kawfey/k3ng_w0odj_keyer-PCB/README.md

# k3ng_w0odj_keyer-PCB

Original K3NG CW Keyer PCB created with Kicad by W0ODJ. https://groups.io/g/radioartisan/message/8825
