kawfey/k3ng_w0odj_keyer-PCB/BOM Mega K3NG.xlsx

Qty | Value | Ref | Description | Price Ea | Price Total | Mouser # / Link
1 |  | BZ1 | Buzzer | $2.18 | $2.18 | 810-SD1614T5-B1
3 | 10nf | C1, C2, C3 | Ceramic Capacitor | $0.03 | $0.09 | https://www.taydaelectronics.com/capacitors/monolithic-ceramic-capacitor/0-01uf-50v-multilayer-monolithic-ceramic-capacitor.html
1 | 100nf | C4 | Ceramic Capacitor | $0.06 | $0.06 | https://www.taydaelectronics.com/capacitors/monolithic-ceramic-capacitor/0-1uf-50v-multilayer-ceramic-capacitor.html
1 | 100uf | C5 | Electrolytic Capacitor | $0.03 | $0.03 | https://www.taydaelectronics.com/capacitors/electrolytic-capacitors/100uf-25v-105c-radial-electrolytic-capacitor-6x11mm.html
4 |  | J1, J2, J3, J4 | TRS Stereo Jack **NOTE FOOTPRINT** | $0.12 | $0.48 | https://www.taydaelectronics.com/hardware/3-5mm-plugs-jacks/3-5mm-stereo-enclosed-socket-chassis-jack.html
1 |  | J5 | MINI-DIN 6 – PS/2 socket | $1.42 | $1.42 | 490-MD-60SM
1 |  | PWR1 | 2.1mm DC Barrel Socket | $0.16 | $0.16 | https://www.taydaelectronics.com/hardware/dc-power/dc-power-jack-2-1mm-barrel-type-pcb-mount.html
2 | PN2222A | Q1, Q2 | TO-92 Transistor | $0.05 | $0.10 | https://www.taydaelectronics.com/pn2222a-pn2222-transistor-npn-40-volts-600-ma.html
3 | 100 | R1, R2, R5 | ¼W Resistor | $0.01 | $0.03 | https://www.taydaelectronics.com/resistors/1-4w-carbon-film-resistors/resistor-100-ohm-1-4w-5-carbon-film-pkg-of-10.html
1 | 10k | R4 | Bourns 10k Linear Pot (PTV09A) | $0.82 | $0.82 | 858-P090L-03F20BR10K
3 | 10k | R7, R13, R14 | ¼W Resistor | $0.01 | $0.03 | https://www.taydaelectronics.com/resistors/1-4w-carbon-film-resistors/10-x-resistor-10k-ohm-1-4w-5-carbon-film-pkg-of-10.html
1 | 220 | R17 | ¼W Resistor | $0.01 | $0.01 | https://www.taydaelectronics.com/resistors/1-4w-carbon-film-resistors/10-x-resistor-220-ohm-1-4w-5-carbon-film-pkg-of-10.html
5 | 1k | R8, R9, R10, R11, R12 | ¼W Resistor | $0.01 | $0.05 | https://www.taydaelectronics.com/resistors/1-4w-carbon-film-resistors/10-x-resistor-1k-ohm-1-4w-5-carbon-film-pkg-of-10.html
1 | 10k | R15 | Bourns 10k 3296W TrimPot | $0.28 | $0.28 | https://www.taydaelectronics.com/potentiometer-variable-resistors/cermet-potentiometers/3296w/10k-ohm-trimmer-potentiometer-cermet-25-turns-3296w.html
1 | SPST | SW0 | SPST Right Angle Slide Switch | $0.72 | $0.72 | 612-EG1224
6 | Tact Switch | SW1, SW2, SW3, SW4, SW5, SW6 | 6mm Tacticle Switch | $0.05 | $0.30 | https://www.taydaelectronics.com/tact-switch-6-6mm-8mm-through-hole-spst-no.html
1 | Arduino | U1 | Arduino Mega 2560 | $12.98 | $12.98 | https://www.ebay.com/itm/MEGA-2560-R3-Board-ATmega2560-16AU-USB-Cable-for-Arduino/252801580596
5 |  | U1*, DSP1* | Single Straight Pin Header 2.54 | $0.15 | $0.75 | https://www.taydaelectronics.com/connectors-sockets/pin-headers/40-pin-2-54-mm-single-row-pin-header-strip.html
1 |  | U1* | Double Straight Pin Header 2.54 | $0.32 | $0.32 | https://www.taydaelectronics.com/connectors-sockets/pin-headers/2x40-pin-2-54-mm-right-angle-double-row-pin-header.html
1 | LED | D1 | 3mm LED | $0.04 | $0.04 | https://www.taydaelectronics.com/leds/round-leds/3mm-leds/blue/led-3mm-blue-water-clear-ultra-bright.html
1 | LCD | DS1 | 1602 LCD Display | $2.09 | $2.09 | https://www.ebay.com/itm/New-Blue-IIC-I2C-TWI-1602-16x2-LCD-Module-Display-for-Arduino/401234985748
4 |  | DS1* | Standoff (spacer) | $0.06 | $0.24 | https://www.ebay.com/itm/25-100pcs-Black-Plastic-Nylon-M2-M3-M4-Hex-Column-Standoff-Spacer-Phillips-Screw/161851888098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
12 |  | U1*, DS1* | Standoff (screw) | $0.03 | $0.36 | https://www.ebay.com/itm/25-100pcs-Black-Plastic-Nylon-M2-M3-M4-Hex-Column-Standoff-Spacer-Phillips-Screw/161851888098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
1 |  | Knob | Knob for R4 | $0.49 | $0.49 | https://www.taydaelectronics.com/hardware/knobs-8688/kn1360-knob-black.html
1 | PCB | PCB | K3NG PCB | $2.20 | $2.20 | JLCPCB
 |  |  | Totals |  | $26.23
10 | Keyers |  | Combined Total |  | $262.30
 |  |  | Total - (minus Arduino & Screen) | $11.16 | $111.60
