kawfey/k3ng_w0odj_keyer-PCB/K3NG Base.stl

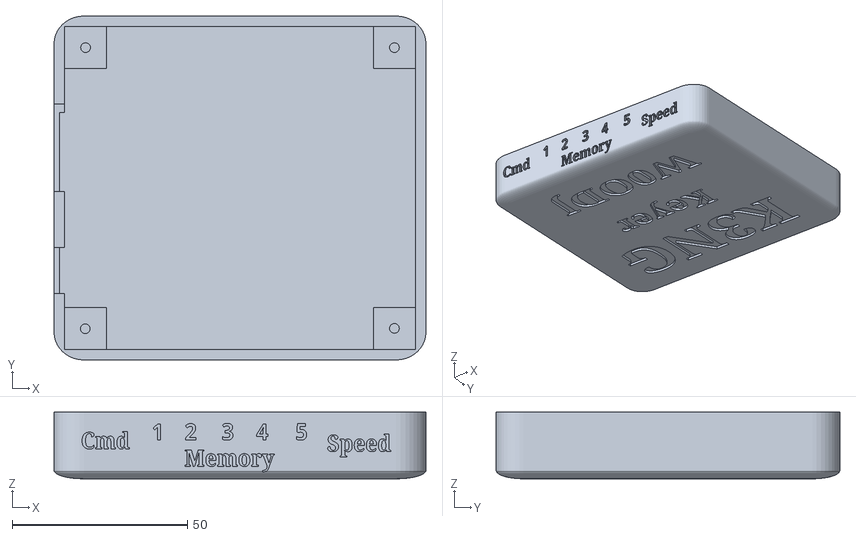
[picture p1: CAD file, 2018-12-13]
K3NG Base.stl
106.0 x 98.0 x 19.0
