kawfey/k3ng_w0odj_keyer-PCB/K3NG KiCAD/K3NG TH Keyer.kicad_pcb

## KiCad design K3NG KiCAD/K3NG TH Keyer.kicad_pcb (2018-12-13)

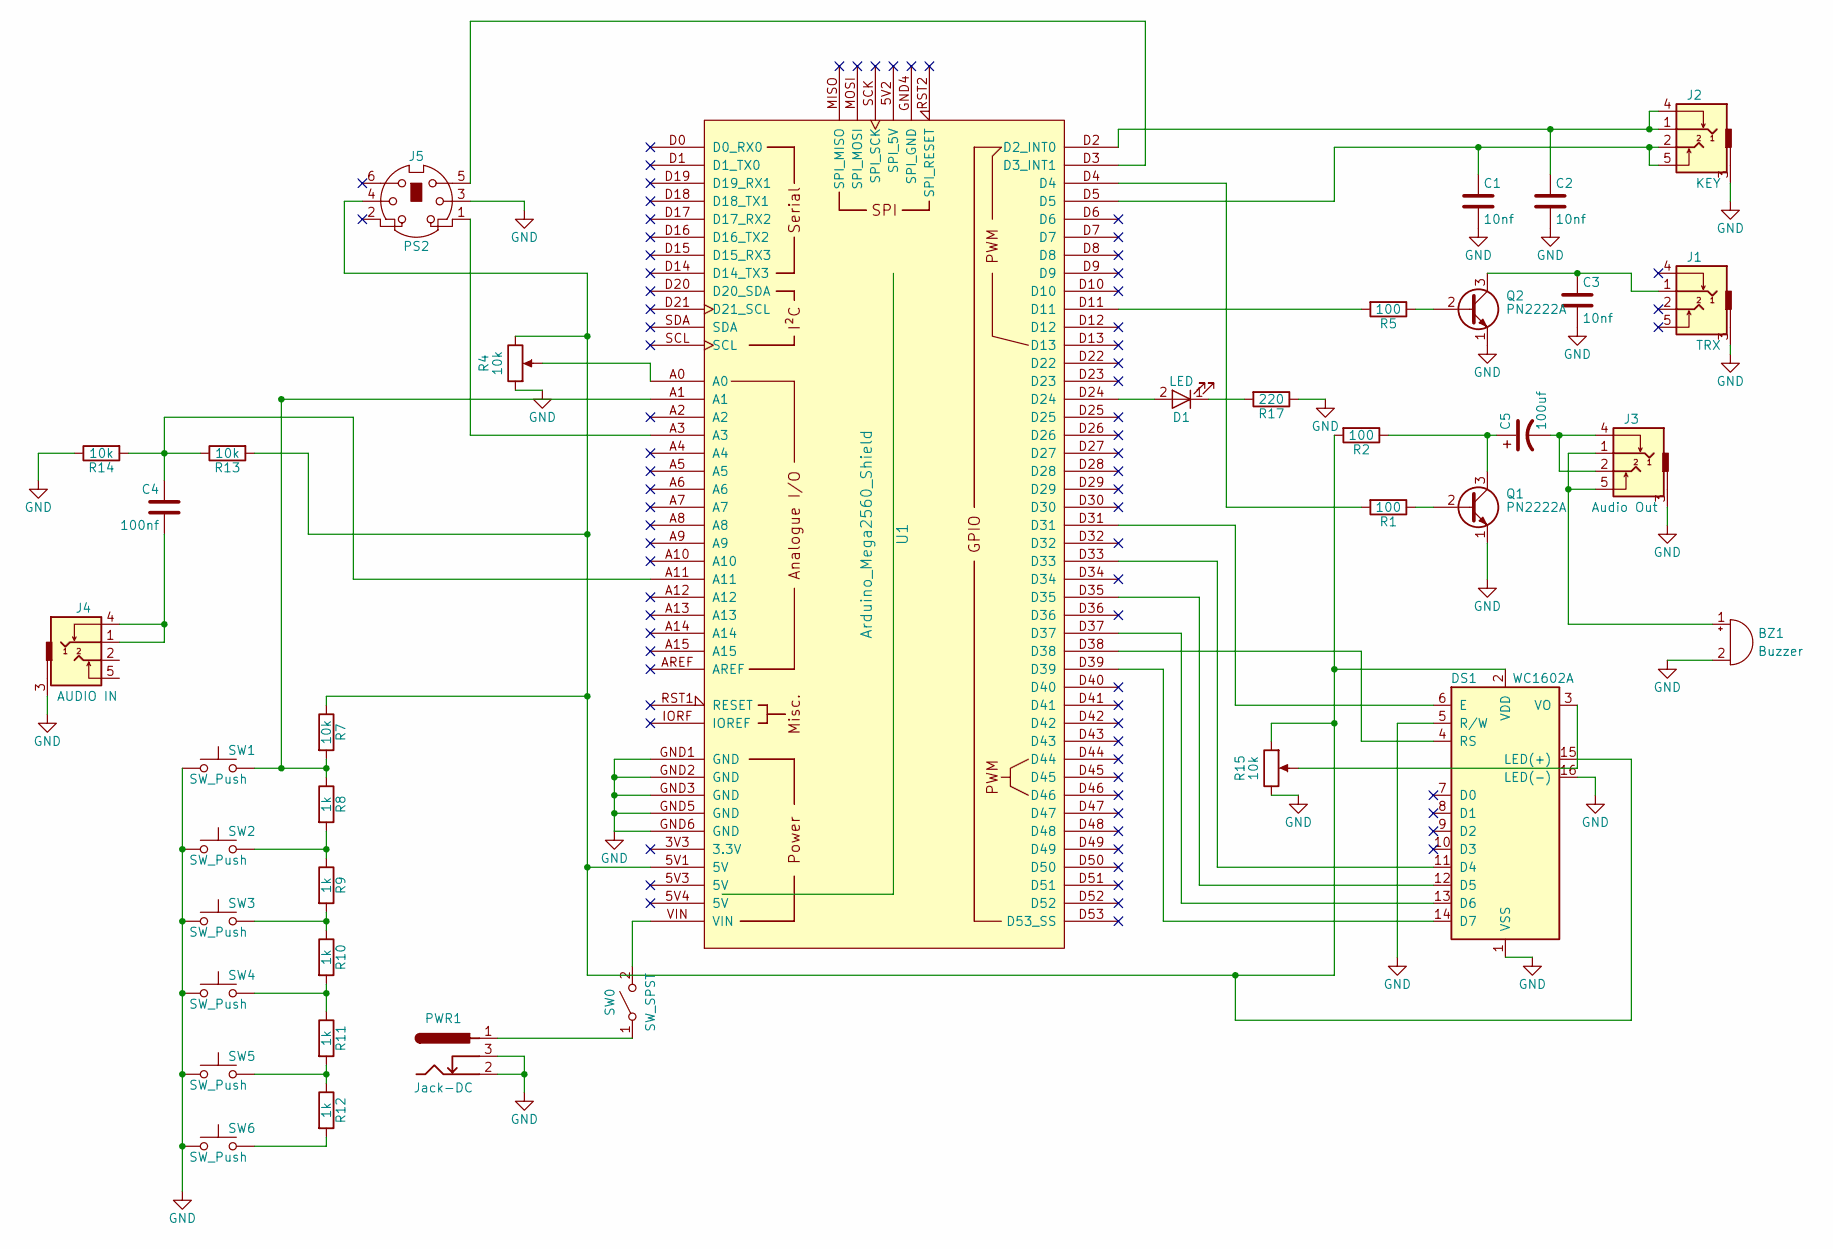
[picture p2: schematic K3NG TH Keyer.sch, K3NG Keyer]

Parts:
BZ1: Buzzer; Buzzer_15x7.5RM7.6; Mouser# 810-SD1614T5-B1
C1, C2, C3: 10nf; C_Disc_D5.0mm_W2.5mm_P5.00mm; Mouser# 810-FA24NP2E103JNU06
C4: 100nf; C_Disc_D5.0mm_W2.5mm_P5.00mm; Mouser# 80-C330C104J2H9170TR
C5: 100uf; CP_Radial_D8.0mm_P3.50mm; Mouser# 598-107RSS025M
D1: LED; LED_D3.0mm
DS1: WC1602A; Mouser# 763-0216K1Z-FSW-FBW
J1: TRX; Tayda_3.5mm_stereo_TRS_jack_A-853; Mouser# 490-SJ1-3525NG
J2: KEY; Tayda_3.5mm_stereo_TRS_jack_A-853; Mouser# 490-SJ1-3525NG
J3: Audio Out; Tayda_3.5mm_stereo_TRS_jack_A-853; Mouser# 490-SJ1-3525NG
J4: AUDIO IN; Tayda_3.5mm_stereo_TRS_jack_A-853; Mouser# 490-SJ1-3525NG
J5: PS2; din6-schurter-4850261; Mouser# 490-MD-60SM
PWR1: Jack-DC; BARREL_JACK; Mouser# 992-CON-SOCJ-2155
Q1, Q2: PN2222A; TO-92_Molded_Narrow; Mouser# 610-PN2222A
R1, R2, R5: 100; R_Axial_DIN0207_L6.3mm_D2.5mm_P10.16mm_Horizontal; Mouser# 279-CFR100J100R
R4: 10k; Potentiometer_Bourns_PTV09A-2_Vertical; Mouser# 858-P090L-03F20BR10K
R7, R13, R14: 10k; R_Axial_DIN0207_L6.3mm_D2.5mm_P10.16mm_Horizontal; Mouser# 660-CF1/4CT52R103J
R8, R9, R10, R11, R12: 1k; R_Axial_DIN0207_L6.3mm_D2.5mm_P10.16mm_Horizontal; Mouser# 603-CFR-25JR-521K
R15: 10k; Potentiometer_Bourns_3296W_3-8Zoll_Inline_ScrewUp; Mouser# 652-3296W-1-103LF
R17: 220; R_Axial_DIN0207_L6.3mm_D2.5mm_P10.16mm_Horizontal
SW0: SW_SPST; SW_E-Switch_EG1224_SPDT_Angled; Mouser# 612-EG1224
SW1, SW2, SW3, SW4, SW5, SW6: SW_Push; SW_PUSH_6mm; Mouser# 688-SKHHBV
U1: Arduino_Mega2560_Shield; Mouser# 782-A000067

Connections:
GND: BZ1.2 (+), C1.2, C2.2, C3.2, DS1.1 (VSS), DS1.5 (R/W), DS1.16 (LED(-)), J1.3, J2.3, J3.3, J4.3, J5.3, PWR1.2, PWR1.3, Q1.1 (E), Q2.1 (E), R4.1, R14.1, R15.3, R17.1, SW1.1, SW2.1, SW3.1, SW4.1, SW5.1, SW6.1, U1.GND1 (GND), U1.GND2 (GND), U1.GND3 (GND), U1.GND5 (GND), U1.GND6 (GND)
unnamed: BZ1.1 (-), J3.1, J3.5
unnamed: C1.1, J2.2, J2.5, U1.D5
unnamed: C2.1, J2.1, J2.4, U1.D2 (D2_INT0)
unnamed: C3.1, J1.1, Q2.3 (C)
unnamed: C4.1, R13.1, R14.2, U1.A11
unnamed: C4.2, J4.1, J4.4
unnamed: C5.1, Q1.3 (C), R2.1
unnamed: C5.2, J3.2, J3.4
unnamed: D1.1 (K), R17.2
unnamed: D1.2 (A), U1.D24
unnamed: DS1.3 (VO), R15.2
unnamed: DS1.4 (RS), U1.D38
unnamed: DS1.6 (E), U1.D31
unnamed: DS1.11 (D4), U1.D33
unnamed: DS1.12 (D5), U1.D35
unnamed: DS1.13 (D6), U1.D37
unnamed: DS1.14 (D7), U1.D39
unnamed: DS1.2 (VDD), DS1.15 (LED(+)), J5.4, R2.2, R4.3, R7.1, R13.2, R15.1, U1.5V1 (5V)
unnamed: J5.1, U1.A3
unnamed: J5.5, U1.D3 (D3_INT1)
unnamed: PWR1.1, SW0.1 (A)
unnamed: Q1.2 (B), R1.1
unnamed: Q2.2 (B), R5.1
unnamed: R1.2, U1.D4
unnamed: R4.2, U1.A0
unnamed: R5.2, U1.D11
unnamed: R7.2, R8.1, SW1.2, U1.A1
unnamed: R8.2, R9.1, SW2.2
unnamed: R9.2, R10.1, SW3.2
unnamed: R10.2, R11.1, SW4.2
unnamed: R11.2, R12.1, SW5.2
unnamed: R12.2, SW6.2
unnamed: SW0.2 (B), U1.VIN

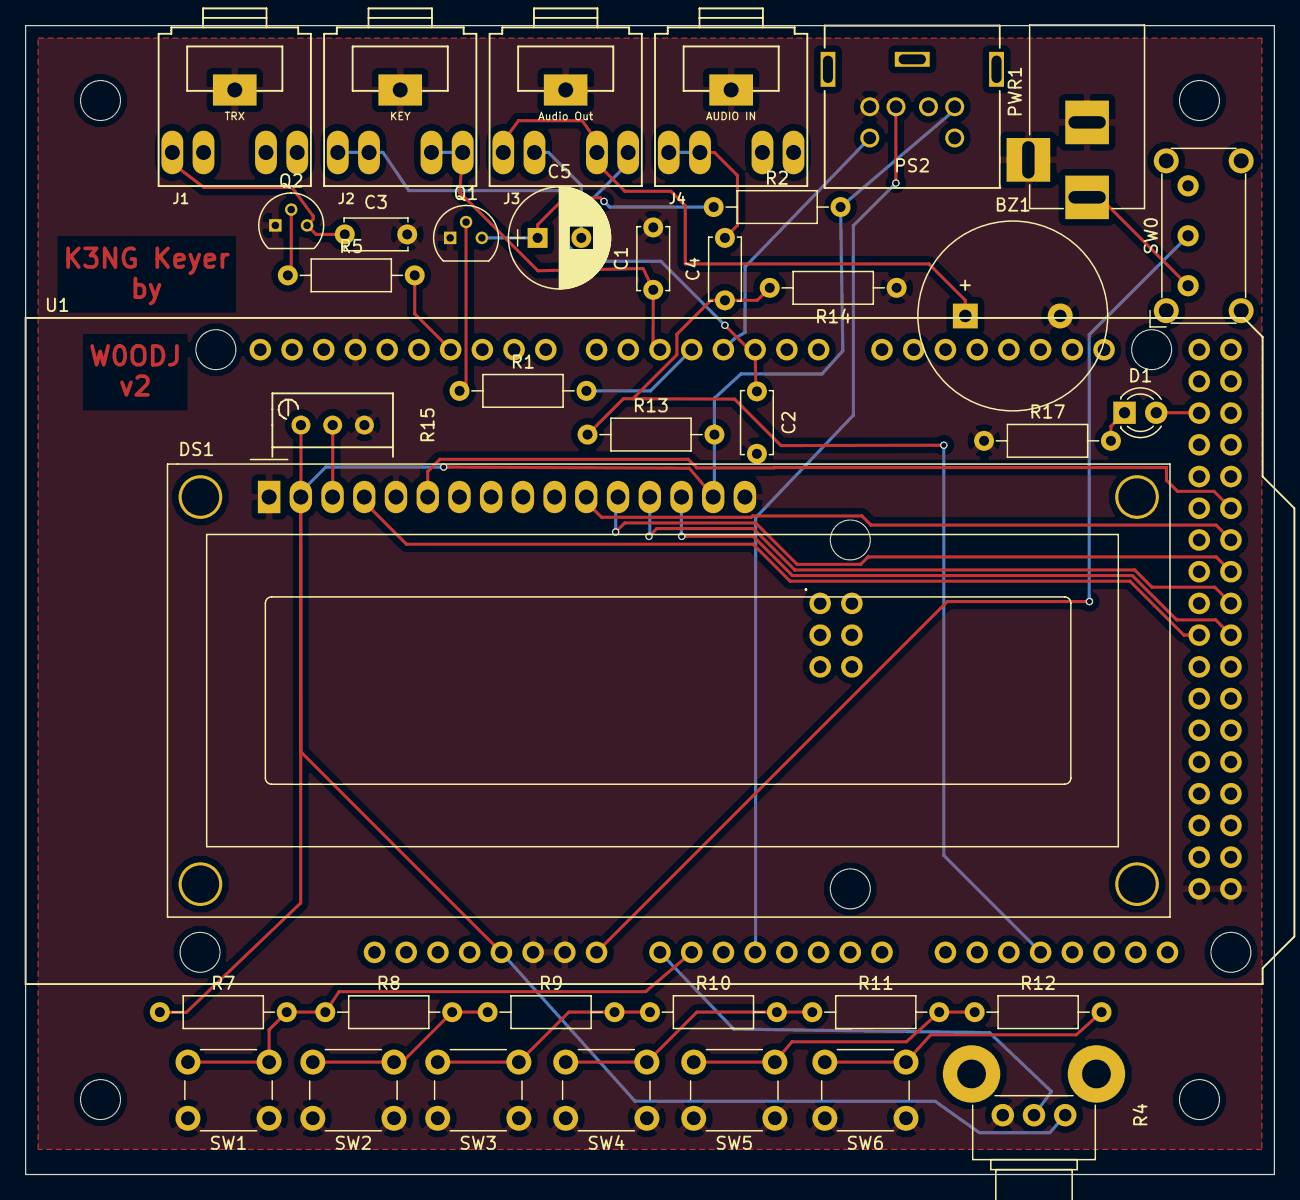
[picture p3: board K3NG TH Keyer.kicad_pcb from above]

Board: 2 copper layers, 100.0 x 92.0 mm, 38 parts (0 on the bottom side), 34 nets.
