kawfey/k3ng_w0odj_keyer-PCB/(commit log)

2018-12-13 Imported files from message
    Source: https://groups.io/g/radioartisan/message/8825
    [BOM Mega K3NG.xlsx, K3NG Base.stl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]
2018-12-13 add kicad to readme
